HussamGawish/IBEX-SOC/Final Milestone/ibex_wrapper/runs/Final_Run/reports/final_summary_report.csv

 | design | design_name | config | runtime | DIEAREA_mm^2 | CellPer_mm^2 | (Cell/mm^2)/Core_Util | OpenDP_Util | Peak_Memory_Usage_MB | cell_count | tritonRoute_violations | Short_violations | MetSpc_violations | OffGrid_violations | MinHole_violations | Other_violations | Magic_violations | antenna_violations | lvs_total_errors | cvc_total_errors | wire_length | vias | wns | pl_wns | optimized_wns | fastroute_wns | spef_wns | tns | pl_tns | optimized_tns | fastroute_tns | spef_tns | HPWL | routing_layer1_pct | routing_layer2_pct | routing_layer3_pct | routing_layer4_pct | routing_layer5_pct | routing_layer6_pct | wires_count | wire_bits | public_wires_count | public_wire_bits | memories_count | memory_bits | processes_count | cells_pre_abc | AND | DFF | NAND | NOR | OR | XOR | XNOR | MUX | inputs | outputs | level | EndCaps
0 | /openLANE_flow/designs/ibex_wrapper | ibex_wrapper | 18-12_18-19 | 0h17m59s | 1.364199 | 18089.736174854257 | 72358.94469941703 | 26 | 1011.35 | 24678 | 0 | 0 | 0 | 0 | 0 | 0 | 19 | 71 | 0 | -1 | 1857600 | 208079 | -6.39 | -6.58 | -6.39 | -10.35 | -6.35 | -18507.53 | -18696.52 | -18507.53 | -24141.48 | -16590.6 | 1572235220 | 0.0 | 26.8 | 28.62 | 4.86 | 2.06 | 0.0 | 24621 | 24738 | 1971 | 2088 | 0 | 0 | 0 | 24678 | 684 | 0 | 393 | 756 | 2425 | 772 | 390 | 6022 | 1994 | 2004 | 61 | 846
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
